medo64/AgIR/Board/AgIR [C].md

### AgIR ###

38 x 25 mm ~ 1.5 sqin

#### Parts ####

|  # | Part | RefDes  | Digi-Key Part Number | Substitute Part Number |
|---:|---|---|---|---|
|  1 | C 10nF, X7R (0805) | C1 | 1276-2984-1-ND | |
|  2 | C 100nF, X7R (0805) | C2 C3 | 399-1170-1-ND | |
|  1 | C 4.7uF, X7R (0805) | C4 | 1276-1065-1-ND | |
|  1 | DS IR 850nm (5mm) | DS1 | 475-2871-ND | |
|  1 | J SWR201-NRTN-S05-RL-WH | J1 | S9451-ND | |
|  1 | L Ferrite 40Ohm (0805) | L1 | 445-2201-1-ND | |
|  1 | Q Phototransistor IR 850nm (5mm) | Q1 | 475-1081-ND | |
|  1 | Q MOSFET, P-channel (SOT23-3) | Q2 | IRLML2246TRPBFCT-ND | DMP3098LDICT-ND |
|  1 | R 100, 0.125W (0805) | R1 | RMCF0805FT100RCT-ND | |
|  2 | R 1K, 0.125W (0805) | R2 R3 | RMCF0805FT1K00CT-ND | |
|  1 | U FT232RL (SSOP-28) | U1 | 768-1007-1-ND | |
