medo64/AgIR/(list of files, drawings)

Other design files:
Board/AgIR [C].dip
