medo64/AgIR/(commit log)

2013-05-06 Initial commit.
    [AgIR [A].dip]
2013-05-10 Changed MOSFET type.
    [AgIR [A].dip]
2013-05-20 Fixed receive.
    [AgIR [A].dip, AgIR [B].dip]
2013-06-07 Removed two resistors.
    [AgIR [B].dip, AgIR [C].dip]
2014-06-15 Updated silk-screen.
    [AgIR [C].dip]
2014-12-14 Updated silkscreen.
    [AgIR [C].dip]
2017-05-28 Changed bear icon.
    [AgIR [C].dip]
2017-06-03 Updated icon
    [AgIR [C].dip]
